koendv/clut-dma/(commit log)

2026-10-31 init
    The experience behind clut-dma: a debugger with an ST7789 and LVGL, where
    the graphics took the RAM and the CPU; a second one with a single-source
    OLED and u8g2. What is wanted, and what the u8g2 clut drivers and clut_dma
    give.
    [m1.cfg]
2026-11-02 clut_dma: horizontal and vertical layout
    [m1.cfg]
2026-11-03 clut_dma: NO_MAP, no tile map README: soldering station example
2026-11-04 doc: rewrite, add arm graphics engine video
